Nebaron12/EXPO40---Pressure-plates/Board files and schematics/Pressure_Plate_Diagram.png

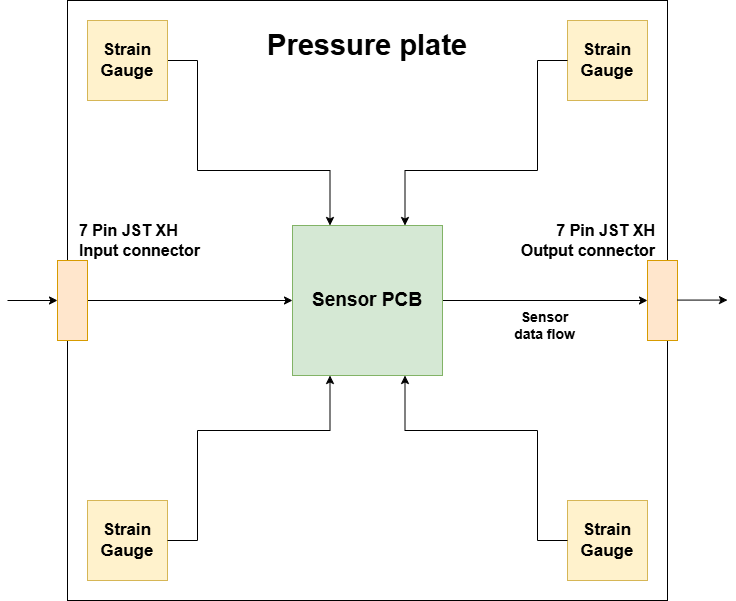
Board files and schematics/Pressure_Plate_Diagram.png
