Nebaron12/EXPO40---Pressure-plates/Board files and schematics/SCH_Schematic1_2025-05-09.pdf

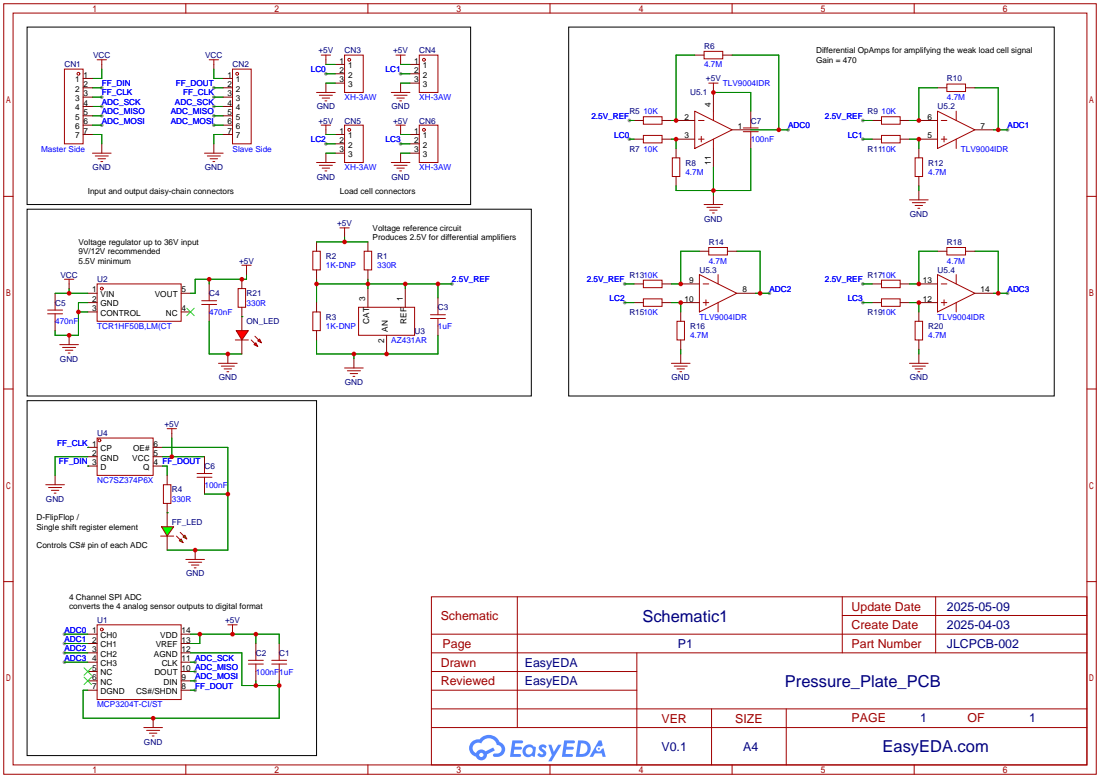
[picture p2: page 1]

Differential OpAmps for amplifying the weak load cell signal
Gain = 470

Input and output daisy-chain connectors

GND
D-FlipFlop /
Single shift register element
Controls CS# pin of each ADC

DOUT 10 CLK 11 AGND 12 VREF 13 VDD 14
