Nebaron12/EXPO40---Pressure-plates/(list of files, drawings)

Other design files:
Board files and schematics/Pressure_Plate_PCB.eprj
