Nebaron12/EXPO40---Pressure-plates/src/MCP320x.h

/*
 Driver library for SPI-based MCP3204/MCP3208 12-bit ADC
 Based on the following sources:
 http://arduino.cc/forum/index.php?topic=53082.0 (see  A. Hinkel library from April 2012-04-26)
 http://arduino.cc/playground/Code/MCP3208	
 A. Hinkel library from April 2012-04-26
 
 Rewritten by Rom3oDelta7 2016-4-5 to conform to new SPI library in IDE 1.6.5 and to allow both 5V and 3.3V operation.
 Types and functions have been redefined so this library is not directly compatible with the previous versions.
 
 For reference, see the Microchip MCP3204/3208 datasheet at http://ww1.microchip.com/downloads/en/DeviceDoc/21298D.pdf
 
 This work is licensed under the Creative Commons Attribution-NonCommercial-ShareAlike 4.0 International License.
 To view a copy of this license, visit http://creativecommons.org/licenses/by-nc-sa/4.0/.
*/


#ifndef MCP320x_H
#define MCP320x_H

#if defined(ARDUINO) && (ARDUINO >= 10605)
#include "Arduino.h"
#else
#error This library requires Arduino IDE 1.6.5 or above
#endif

#include "FF.h"

#define	MCP_MAX_PORTS		8
#define MCP_ALL_PORTS		0
#define MCP_CHANNEL_ERROR	0xFFFF					// return code for channel out of range (not used for MODE)

typedef enum { MCP_SINGLE, MCP_DIFFERENTIAL, MCP_RANGE_ERROR } MCPMode;


class MCP320x {
  public:
	// constructors 
    // MCP320x(uint8_t CS, uint8_t DIN, uint8_t DOUT, uint8_t CLK);						// pin mode (~7-8x SLOWER than SPI mode)
    MCP320x(uint8_t adc_count, const uint8_t channel_count, const uint8_t ff_data_pin, const uint8_t ff_clk_pin);																// SPI mode
	
	// user functions
    uint16_t	readChannel(uint8_t adc, uint8_t channel);											// read the selected MCP channel
    bool 		readAllChannels(uint8_t adc, uint16_t channelValue[]);			// read all channels up to count into given array
    MCPMode 	getMCPConfig(uint8_t channel);											// get SGL/DIFF config for given channel
    bool 		setMCPConfig(MCPMode mode, uint8_t channel);							// set channel SGL/DIFF config for a channel (MCP_ALL_PORTS to set all channels)
    float 		rawToVoltage(float VREF, uint16_t ADCRawValue);							// convert ADC raw value to volts using given reference voltage (MCP VREF pin)

  private:
    MCPMode		_DeviceMode[MCP_MAX_PORTS];			// MCP sampling mode configuration
    uint8_t   _MCP_channelCount;       // Number of channels in the MCP (4 or 8)
    FF        _flipFlopCS;        // Flip flop based shift register for chip selecting
    uint8_t   _numADCs;           // Number of ADCs selectable by FF shift register
    uint8_t   _curADC;            // Currently selected ADC by FF shift register
    uint8_t		_CS;								// chip select
    uint8_t		_DOUT;								// MCP Dout (MISO)
    uint8_t		_DIN;								// MCP Din (MOSI)
    uint8_t		_CLK;								// clock pin
    uint16_t 	_read_SPI(uint8_t adc, uint8_t channel);			// private read functions based on mode
    void      _setCS(uint8_t selected_adc);				// set the CS line for the given channel (SPI mode)
    // uint16_t 	_read_pin(uint8_t channel); // used for pin mode only
    // void 		_clockTick(uint8_t n);				// used for pin mode only
};

#endif
