Nebaron12/EXPO40---Pressure-plates/(commit log)

2025-07-02 Final version, ready for handover to the next team.
    [Pressure_Plate_PCB.eprj]
2025-07-07 Updated pressure plate diagram
